rattboi/loadframe-capstone-psu2013/doc/Top Level Diagram.png

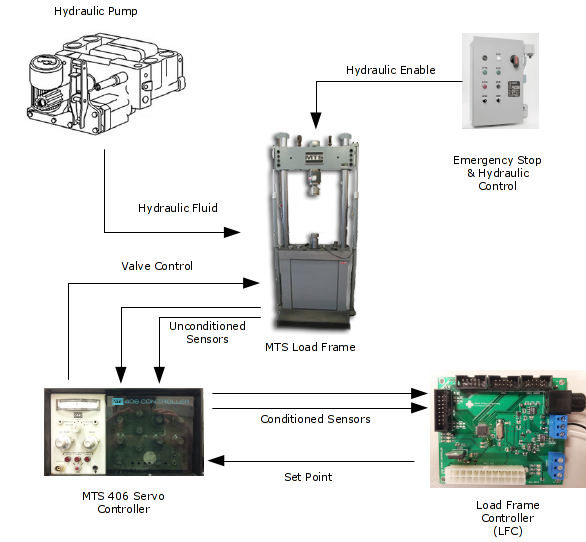
doc/Top Level Diagram.png
