rattboi/loadframe-capstone-psu2013/README.md

loadframe-capstone-psu2013
==========================
