rattboi/loadframe-capstone-psu2013/simulations/DACAmplifier.asc

R1: res; 10k
R2: res; 10k
R3: res; 20k
R4: res; 16.9k
R5: res; 100k
U3: LT6011
U4: LT6011
V1: voltage; 12
V2: voltage; 12
V3: voltage; SINE(2.048 2.048 1 .0 0 0); AC 2.5
V4: voltage; -4.096
Named nets: 0, V+, V-, Vo, Vi
.tran 0 2 0 .05
