rattboi/loadframe-capstone-psu2013/simulations/ADCamplifier.asc

R1: res; 10k
R2: res; 59k
R3: res; 20k
U2: LT6011
V1: voltage; 12
V2: voltage; 12
V3: voltage; SINE(0 10 1 0 0 0 2)
V4: voltage; -4.096
Named nets: 0, V+, V-, Vo, Vi
.tran 0 2 0 .05
