rattboi/loadframe-capstone-psu2013/(list of files, drawings)

Other design files:
cad/analog/frame-control.dsn
