rattboi/loadframe-capstone-psu2013/cad/display/display.kicad_pcb

## KiCad design cad/display/display.kicad_pcb (2013-05-29)

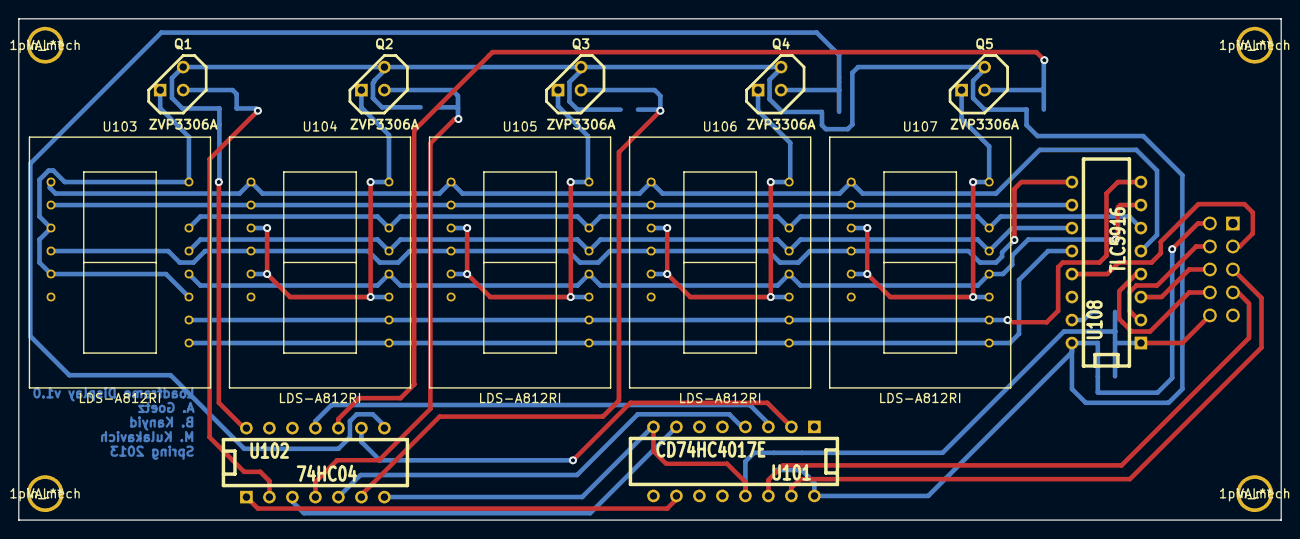
[picture p5: board display.kicad_pcb from above]

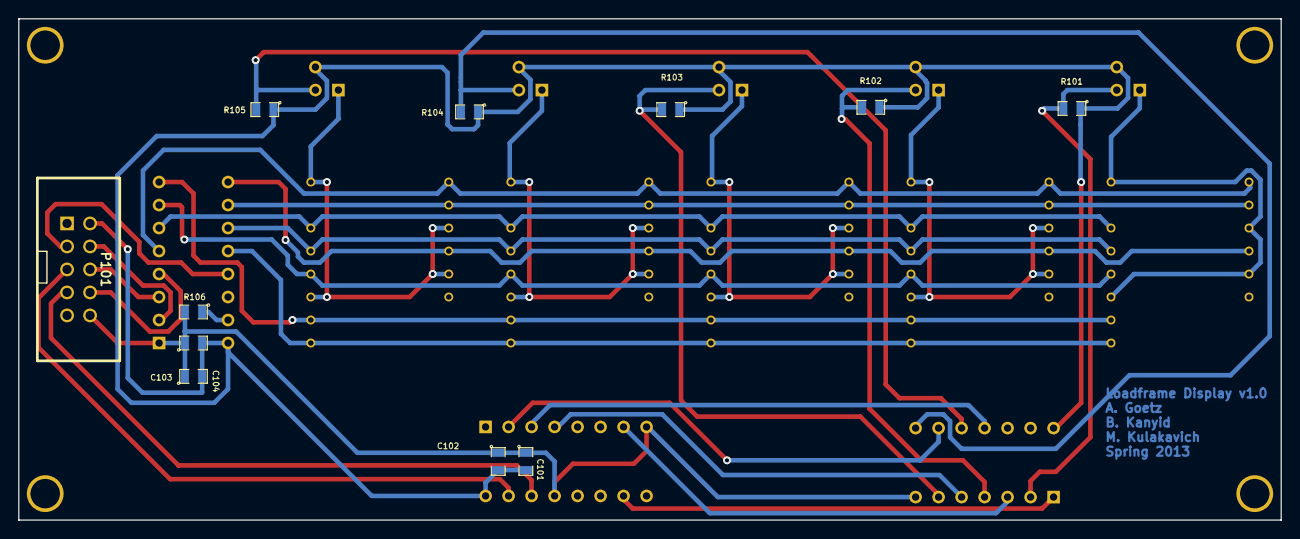
[picture p6: board display.kicad_pcb from below]

Board: 2 copper layers, 139.4 x 55.4 mm, 28 parts (11 on the bottom side), 32 nets.

Parts:
1pin_mech, 1pin_mech#2, 1pin_mech#3, 1pin_mech#4: VAL**; 1pin_mech
C101, C103: 100nF; SM0805
C102, C104: 1uF; SM0805
P101: CONN_5X2; shrouded_5x2
Q1, Q2, Q3, Q4, Q5: ZVP3306A; TO92-123
R101, R102, R103, R104, R105: 10K; SM0805
R106: 750; SM0805
U101: CD74HC4017E; DIP-16__300
U102: 74HC04; DIP-14__300
U103, U104, U105, U106, U107: LDS-A812RI
U108: TLC5916; DIP-16__300

Connections:
+5V: C101.2, C102.2, C103.2, C104.2, P101.2, Q1.1, Q2.1, Q3.1, Q4.1, Q5.1, R101.1, R102.1, R103.1, R104.1, R105.1, U101.16, U102.14, U108.16
/A: U103.1, U104.1, U105.1, U106.1, U107.1, U108.5
/B: U103.14, U104.14, U105.14, U106.14, U107.14, U108.6
/C: U103.12, U104.12, U105.12, U106.12, U107.12, U108.7
/D: U103.10, U104.10, U105.10, U106.10, U107.10, U108.8
/E: U103.4, U104.4, U105.4, U106.4, U107.4, U108.9
/F: U103.2, U104.2, U105.2, U106.2, U107.2, U108.10
/G: U103.13, U104.13, U105.13, U106.13, U107.13, U108.11
/RDP: U103.9, U104.9, U105.9, U106.9, U107.9, U108.12
GND: C101.1, C102.1, C103.1, C104.1, P101.10, R106.2, U101.8, U101.13, U102.7, U108.1
unnamed: Q4.3, U106.3, U106.5, U106.11, U106.16
unnamed: U101.3, U102.11
unnamed: Q1.3, U103.3, U103.5, U103.11, U103.16
unnamed: U101.10, U102.1
unnamed: R106.1, U108.15
unnamed: P101.3, U108.13
unnamed: P101.8, U108.4
unnamed: P101.6, U108.3
unnamed: P101.4, U108.2
unnamed: U101.7, U102.3
unnamed: Q5.2, R105.2, U102.10
unnamed: Q4.2, R104.2, U102.8
unnamed: Q1.2, R101.2, U102.2
unnamed: Q2.3, U104.3, U104.5, U104.11, U104.16
unnamed: Q3.2, R103.2, U102.6
unnamed: Q3.3, U105.3, U105.5, U105.11, U105.16
unnamed: U101.2, U102.9
unnamed: Q2.2, R102.2, U102.4
unnamed: Q5.3, U107.3, U107.5, U107.11, U107.16
unnamed: U101.4, U102.5
unnamed: P101.7, U101.14
unnamed: P101.5, U101.15
