rattboi/loadframe-capstone-psu2013/cad/analog/frame-control.kicad_pcb

## KiCad design cad/analog/frame-control.kicad_pcb (2013-03-28)

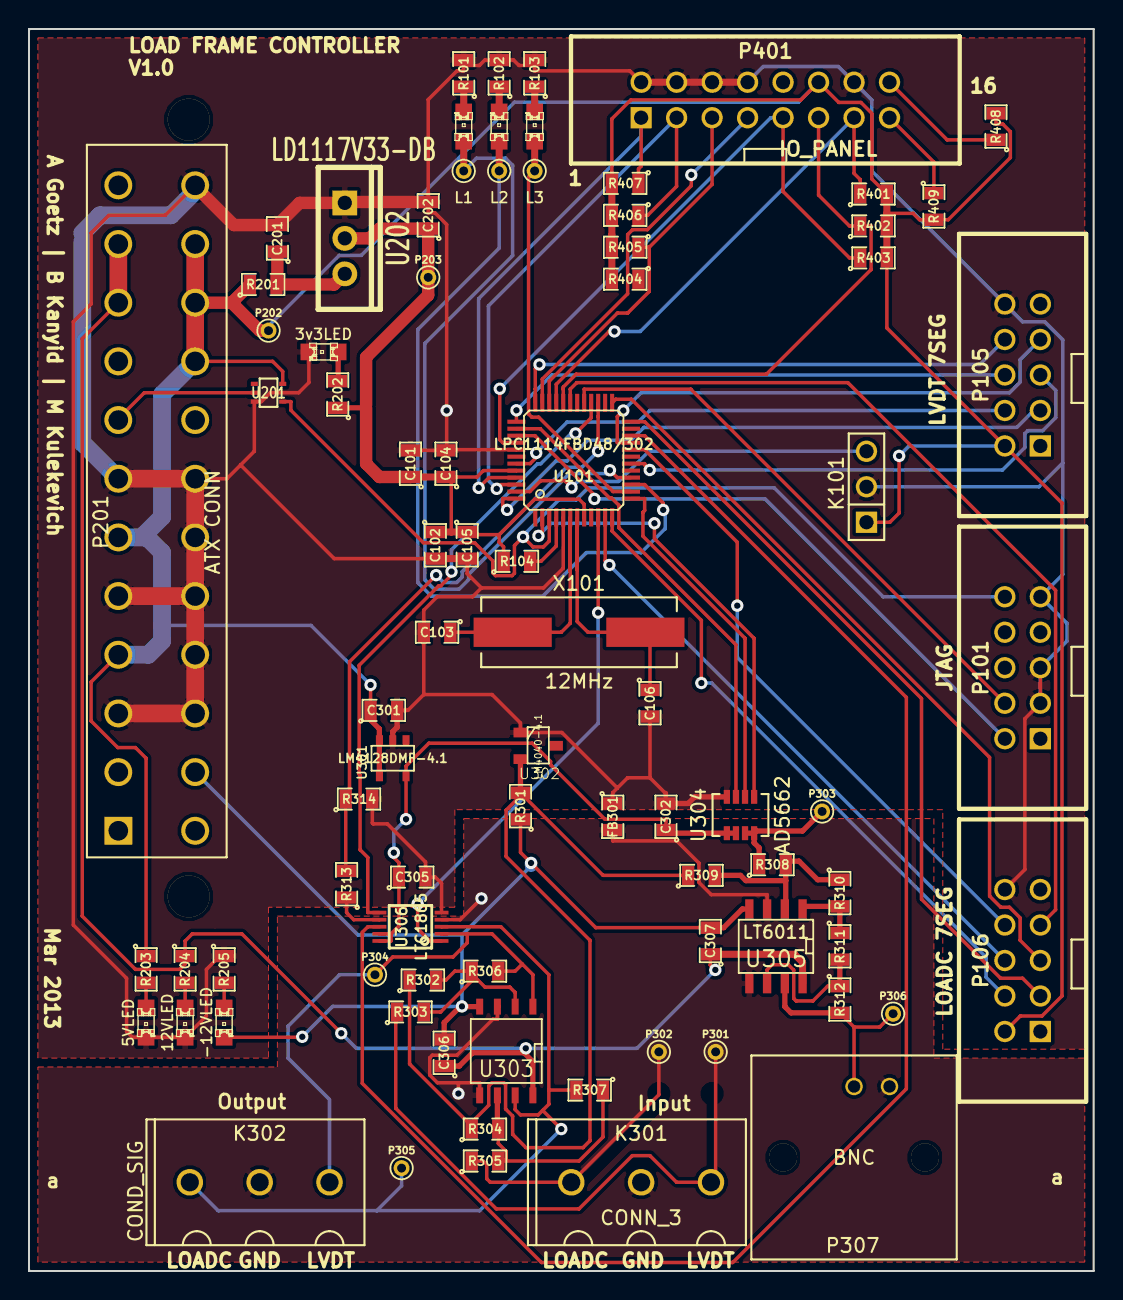
[picture p7: board frame-control.kicad_pcb from above]

Board: 2 copper layers, 76.2 x 88.9 mm, 83 parts (0 on the bottom side), 67 nets.

Parts:
C101, C102, C302, C305, C306, C307: 100n; SM0805
C103, C106: 18pF; SM0805
C104, C105: 10n; SM0805
C201, C202: 1u; SM0805
C301: 4.7u; SM0805
D101: L1; LED-0805
D102: L2; LED-0805
D103: L3; LED-0805
D201: 3v3LED; LED-0805
D202: 5VLED; LED-0805
D203: 12VLED; LED-0805
D204: -12VLED; LED-0805
FB301: FILTER; SM0805
K101: LCD; PIN_ARRAY_3X1
K301: CONN_3; OSTTA030161
K302: COND_SIG; OSTTA030161
P101: JTAG; shrouded_5x2
P102, P103, P104, P202, P203, P301, P302, P303, P304, P305, P306: TST; PINTST
P105: LVDT; shrouded_5x2
P106: LOADC; shrouded_5x2
P201: ATX CONN; 39-29-9242
P307: BNC; TE-1-1634612-0
P401: IO_PANEL; shrouded_8x2
R101, R102, R103, R202, R203, R204, R205: 1.5k; SM0805
R104, R306, R307, R308, R310, R313, R314, R403, R404, R405, R406, R407, R408, R409: 10k; SM0805
R201: 0; SM0805
R301: 500; SM0805
R302, R304, R309: 20k; SM0805
R303, R305: 59k; SM0805
R311: 17k; SM0805
R312: 100k; SM0805
R401, R402: 5.1k; SM0805
U101: LPC1114FBD48/302; lqfp48
U201: 74LVCE1G06; SOT353
U202: LD1117V33-DB; TO220_VERT_FIX
U301: LM4128DMF-4.1; SOT23-5
U302: LM4040-4.1; SOT23
U303: LT6011; SO8N
U304: AD5662; SOT23-8
U305: LT6011; SO8E
U306: LTC1865; MSOP10-0.5
X101: 12MHz; HC-49-US

Connections:
+3.3V: C101.1, C102.1, C104.1, C105.1, C202.1, P203.1, R104.1, R202.1, U101.8, U101.44, U202.2
+5V: C301.1, K101.1, P105.2, P106.2, P201.4, P201.6, P201.21, P201.22, P201.23, P202.1, P401.12, R201.1, R203.1, R401.2, R402.2, R403.2, R404.2, R405.2, R406.2, R407.2, R408.2, R409.2, U201.5, U301.3, U301.4
+5VA: C302.1, C305.1, U301.5, U304.1, U304.2, U306.9, U306.10
+12V: C306.1, C307.1, P201.10, P201.11, R204.1, U303.8, U305.8
-12V: C306.2, C307.2, D204.2, P201.14, R301.1, U303.4, U305.4
/Analog Frontend/ADCCLK: U101.22, U306.8
/Analog Frontend/ADCEN: U101.10, U306.1
/Analog Frontend/ADCI: U101.28, U306.6
/Analog Frontend/ADCO: R313.2, R314.1, U101.27
/Analog Frontend/DACCLK: U101.13, U304.6
/Analog Frontend/DACIN: U101.38, U304.7
/Analog Frontend/~DACEN: U101.2, U304.5
/InterfaceButtons/Aux1: P401.15, R409.1
/InterfaceButtons/Aux2: P401.16, R408.1
/InterfaceButtons/ESTOP: P401.5, R405.1, U101.34
/InterfaceButtons/EncoderA: P401.11, R402.1, U101.32
/InterfaceButtons/EncoderB: P401.13, R401.1, U101.33
/InterfaceButtons/TareLOADC: P401.3, R406.1, U101.46
/InterfaceButtons/TareLVDT: P401.1, R407.1, U101.45
/InterfaceButtons/ToggleA: P401.7, R404.1, U101.35
/InterfaceButtons/ToggleB: P401.9, R403.1, U101.40
/Power/PWRGD: P101.10, U101.3, U201.4
AGND: FB301.2, K301.2, K302.2, P307.2, U303.3, U303.5, U305.3, U305.5, U306.4
GND: C101.2, C102.2, C103.2, C104.2, C105.2, C106.2, C201.2, C202.2, C301.2, C302.2, C305.2, D201.2, D202.2, D203.2, FB301.1, K101.2, P101.3, P101.5, P101.9, P105.10, P106.10, P201.3, P201.5, P201.7, P201.15, P201.16, P201.17, P201.18, P201.19, P201.24, P401.2, P401.4, P401.6, P401.8, P401.14, R101.2, R102.2, R103.2, R205.1, R314.2, U101.5, U101.41, U201.3, U202.1, U301.2, U302.1, U304.8, U306.5
unnamed: P106.6, U101.11
unnamed: P106.8, U101.20
unnamed: C103.1, U101.6, X101.1
unnamed: C106.1, U101.7, X101.2
unnamed: P105.6, U101.37
unnamed: P105.8, U101.36
unnamed: P106.5, U101.25
unnamed: P105.5, U101.18
unnamed: P105.3, U101.48
unnamed: P105.4, U101.43
unnamed: P106.7, U101.31
unnamed: P106.3, U101.24
unnamed: P106.4, U101.12
unnamed: R104.2, U101.4
unnamed: P105.7, U101.21
unnamed: K101.3, U101.47
unnamed: P101.4, U101.29
unnamed: P101.2, U101.39
unnamed: D102.1, P103.1, U101.15
unnamed: D102.2, R102.1
unnamed: D101.1, P102.1, U101.16
unnamed: D101.2, R101.1
unnamed: D103.1, P104.1, U101.14
unnamed: D103.2, R103.1
unnamed: R313.1, U306.7
unnamed: R302.2, R303.2, R306.1, U303.2
unnamed: K302.3, P304.1, R306.2, U303.1, U306.2
unnamed: K301.3, P301.1, R303.1
unnamed: R301.2, R302.1, R304.1, R309.1, U302.2
unnamed: K301.1, P302.1, R305.1
unnamed: P303.1, R308.1, U304.3, U304.4
unnamed: R308.2, R309.2, R310.1, U305.2
unnamed: K302.1, P305.1, R307.2, U303.7, U306.3
unnamed: P306.1, P307.1, R312.2, U305.7
unnamed: R304.2, R305.2, R307.1, U303.6
unnamed: R310.2, R311.1, U305.1
unnamed: R311.2, R312.1, U305.6
unnamed: D201.1, R202.2
unnamed: D202.1, R203.2
unnamed: D204.1, R205.2
unnamed: D203.1, R204.2
unnamed: C201.1, R201.2, U202.3
unnamed: P201.8, U201.2
