rattboi/loadframe-capstone-psu2013/code/loadframe/src/gpio.h

/*****************************************************************************
 *   $Id:: gpio.h 4790 2010-09-03 23:35:38Z nxp21346                        $
 *   Project: NXP LPC11xx software example
 *
 *   Description:
 *     This file contains definition and prototype for GPIO.
 *
 ****************************************************************************
 * Software that is described herein is for illustrative purposes only
 * which provides customers with programming information regarding the
 * products. This software is supplied "AS IS" without any warranties.
 * NXP Semiconductors assumes no responsibility or liability for the
 * use of the software, conveys no license or title under any patent,
 * copyright, or mask work right to the product. NXP Semiconductors
 * reserves the right to make changes in the software without
 * notification. NXP Semiconductors also make no representation or
 * warranty that such application will be suitable for the specified
 * use without further testing or modification.
****************************************************************************/
#ifndef __GPIO_H 
#define __GPIO_H

#if CONFIG_ENABLE_DRIVER_GPIO==1

#define PORT0		0
#define PORT1		1
#define PORT2		2
#define PORT3		3
static LPC_GPIO_TypeDef (* const LPC_GPIO[4]) = { LPC_GPIO0, LPC_GPIO1, LPC_GPIO2, LPC_GPIO3 };
void PIOINT0_IRQHandler(void);
void PIOINT1_IRQHandler(void);
void PIOINT2_IRQHandler(void);
void PIOINT3_IRQHandler(void);
void GPIOInit( void );
void GPIOSetInterrupt( uint32_t portNum, uint32_t bitPosi, uint32_t sense,
		uint32_t single, uint32_t event );

void GPIOIntEnable( uint32_t portNum, uint32_t bitPosi );
void GPIOIntDisable( uint32_t portNum, uint32_t bitPosi );
uint32_t GPIOIntStatus( uint32_t portNum, uint32_t bitPosi );
void GPIOIntClear( uint32_t portNum, uint32_t bitPosi );
void GPIOSetValue( uint32_t portNum, uint32_t bitPosi, uint32_t bitVal );
void GPIOSetDir( uint32_t portNum, uint32_t bitPosi, uint32_t dir );
#endif
#endif /* end __GPIO_H */
/*****************************************************************************
**                            End Of File
******************************************************************************/
