rattboi/loadframe-capstone-psu2013/(commit log)

2013-02-27 Added LTSpice simulations of OPAMP circuits
2013-02-27 Changed references in opamp circuits to be -5.0 volts
2013-02-27 started work on kicad schematic
    [frame-control.sch]
2013-03-01 Wired up ADC and DAC
    [Analog.sch, frame-control.sch]
2013-03-06 Moved Andy's analog frontend into it's own directory
    [Analog.sch, frame-control.sch]
2013-03-06 Added .gitignore for annoying Kicad backups Added root to display board
    [display.sch]
2013-03-08 First version of display schematic
    [display.sch]
2013-03-22 added support logic to analog drawing
    [Analog.sch, frame-control.sch]
2013-03-25 Finished first version of schematic
    [Analog.sch, Interface.sch, Power.sch, frame-control.sch]
2013-03-26 started work on analog pcb
    [Analog.sch, Interface.sch, Power.sch, frame-control.kicad_pcb, frame-control.sch]
2013-03-28 added a lot more to the pcb design
    [Analog.sch, Interface.sch, Power.sch, frame-control.dsn, frame-control.kicad_pcb, frame-control.sch]
2013-03-28 fixed issue with weird rendered blobs in gerbers
    [frame-control.kicad_pcb]
2013-03-29 added psu logo and adjust some traces
2013-04-05 modified schematic to add stapling
    [frame-control.dsn]
2013-04-10 Updated schematic layout
    [Analog.sch, Interface.sch, Power.sch, frame-control.dsn, frame-control.sch]
2013-04-10 Added moar ferrite beads and widened power traces
    [Analog.sch, Interface.sch, Power.sch, frame-control.sch]
2013-04-11 Changed a power trace width
2013-04-12 1st pass on display layout. Footprints need work
    [display.kicad_pcb, display.sch]
2013-04-13 Rev2 of displayboard,needs borders + holes
    [display.kicad_pcb, display.sch]
2013-04-13 Added bom files
2013-04-13 Modified values to be values that can be found on digikey
    [Analog.sch, Interface.sch, Power.sch, frame-control.sch]
2013-04-13 Added readme to bom directory
2013-04-13 Committing the real v2 display layout
    [display.kicad_pcb]
2013-04-13 Added csv of frame-control bom
    [frame-control.csv]
2013-04-14 Ground fills added, mounting holes too
    Text also added. I think this is done.
    [display.kicad_pcb]
2013-04-14 Created BOM for display board
2013-04-14 Filter more files in .gitignore
2013-04-14 Rev2 of board w/ right transistors (PMOS SUCKS)
    [display.kicad_pcb, display.sch]
2013-04-14 Modified loadframe pcb to have additionaly auxiliary button
    [Analog.sch, Interface.sch, Power.sch, frame-control.sch]
2013-04-18 PCB update (remove groundplane for EPL print)
    [display.kicad_pcb]
2013-04-27 Worked on dac driver. Think it works naow
2013-04-29 Added support for adc
2013-05-10 Changed trace width to 20 mils. Had to move some things around
    [display.kicad_pcb]
2013-05-22 Blinking works, some buttons work, both screens work
2013-05-25 Got toggle and encoder functions, verified the I/O
    need to work on the logic
2013-05-27 Updated PCBs with latest changes
    [Analog.sch, Interface.sch, Power.sch, display.kicad_pcb, display.sch, frame-control.sch]
2013-05-27 Numbers works better, refactored some encoder stuff
2013-05-29 conv_to_voltage for DAC is working, with some samples
2013-05-29 Added most of the mode logic. It's broke right now though
    [main.c, sseg.c, sseg.h]
2013-05-30 Everything is working, except loadcell and some feedback issues
    Setpoint stuff needs to be better
    [main.c, sseg.h]
2013-06-01 Added stub for loadcell scaling, also fixed math for conversions
    [main.c]
2013-06-02 Fixed voltage directions in manual
2013-06-13 Added support for speed control (preliminary)
    Timer added for specific control of speed
    A bunch of other stuff
    [Analog.sch, Interface.sch, Power.sch, frame-control.sch]
